Ayan161897/Impedance-git/EIS_Project_Presentation.pptx

Electrochemical Impedance Spectroscopy

EIS Measurement System

Master's Thesis | STM32F303CCT6 | Python Desktop GUI

Portable swept-sine EIS instrument for electrochemical electrode characterization

2026

## Slide 2

Project Overview

A compact USB-controlled EIS instrument for master's thesis electrochemical research

What it is
A portable electrochemical impedance spectroscopy (EIS) instrument built around the STM32F303CCT6 microcontroller. It sweeps a sinusoidal excitation signal across a user-defined frequency range and measures complex impedance at each step.
How it works
An AD9833 DDS chip generates the stimulus sine wave. The signal passes through a TIA stage and both the reference and TIA channels are simultaneously digitized by a dual-channel ADC with DMA (256 samples each). A least-squares tone estimator extracts magnitude and phase at the exact measurement frequency.
Key outputs
Bode plots (|Z| and phase vs. frequency) and a Nyquist plot (Re(Z) vs. -Im(Z)) are displayed live in the Python desktop GUI. All sweep data is also logged to on-board W25Q32 SPI flash and can be exported as CSV.

PC — Python GUI (PyQt5)

USB-UART (CP2102 Bridge)

STM32F303CCT6 Firmware

AD9833 DDS -> Signal Chain

ADC + Tone Estimator -> Z(f)

## Slide 3

EIS Theory & Measurement Principle

Electrochemical Impedance Spectroscopy — the physics behind the measurement

What is Impedance?
Impedance Z(f) = V(f) / I(f) — the complex ratio of voltage to current at each frequency. It extends resistance to the complex plane: Z = Re(Z) + j·Im(Z).
Swept-Sine Method
A pure sine wave at frequency f is applied to the electrochemical cell. The resulting current (or voltage across a reference resistor) is measured. Magnitude |Z| = V_exc / I_resp and phase angle phi = angle(V) - angle(I) are extracted at each frequency step.
Randles Circuit Model
A simple electrochemical cell can be modelled as: solution resistance Rs in series with the parallel combination of double-layer capacitance Cdl and charge-transfer resistance Rct. This gives a characteristic semicircle on the Nyquist plot.
Applications
Battery state-of-health, corrosion monitoring, biosensor characterization, membrane impedance, supercapacitor analysis.

Randles Equivalent Circuit

Cdl
(Double-layer
Capacitance)

Rct
(Charge-transfer
Resistance)

Rs
(Solution
Resistance)

Current I

Electrode / DUT

Nyquist Plot — Randles Semicircle

<--- Rct diameter --->

^ -Im(Z)

Re(Z) ->

Rs

Rs+Rct

## Slide 4

System Specifications & Key Parameters

Hardware and software performance figures for the EIS instrument

Frequency range
1 Hz – 100 kHz (software limit; ADC Nyquist ~121 kHz)

ADC sample rate
72 MHz / ((61.5+12.5)x2) = 486 kHz total; 243 kHz per channel

Samples per step
256 per channel (512 ADC words per frequency point via DMA)

DDS resolution
25 MHz / 2^28 = 0.093 Hz (AD9833 with 25 MHz MCLK)

Impedance formula
Z = (|V_ref| / |V_sig|) x Rf ; phi = angle(V_sig) - angle(V_ref)

Flash storage
~390 records in 16 KB log region (4 x 4 KB sectors of W25Q32)

UART protocol
115 200 baud, 8N1, ASCII line protocol (CR+LF terminated)

Supply voltage
USB-C 5 V -> MCP1700 LDO -> 3.3 V (250 mA max)

Reference voltage
ADR4533BRZ 3.3 V precision ref for STM32 VDDA and VREF+

System clock
8 MHz HSE crystal -> STM32 PLL x9 = 72 MHz

SPI clock
36 MHz (SPI1 prescaler /2 from 72 MHz for AD9833 and W25Q32)

Phase accuracy
Determined by ADC sample timing precision and 486 kHz sample rate

## Slide 5

Python Desktop GUI

PyQt5 | Matplotlib | PySerial | NumPy — cross-platform, install via pip

Port: COM5 [Connect] [Start] [Stop] [Status] [Flash] [Export]

Nyquist

<- DATA,5000,1234.56,-23.45 -> START <- SWEEP,BEGIN

Connection & Control
Port selector, baud, Connect/Disconnect. Start Sweep, Stop, Status, Flash Status, Dump Flash, Erase Flash.
Sweep Configuration
Start freq, stop freq, step freq, feedback Rf — applied live via SET_* UART commands.
Live Plots
Bode |Z| (log-log), Bode phase (log-x), Nyquist (Re vs -Im) — all update point-by-point during sweep.
Status Panel
Live state (IDLE/RUNNING), current frequency, points done, flash record count & capacity.
Color-Coded Serial Console
Green = received, Blue = sent, Red = errors. Full UART log visible at all times.
Data Export
One-click CSV export: freq, |Z|, phase, Re(Z), Im(Z). Flash dump also populates plots.

Sweep Config

Start: 1000 Hz
Stop: 100000 Hz
Step: 1000 Hz
Rf: 10000
[Apply]

Live Status

State: RUNNING
Freq: 5000 Hz
Pts: 4/99
Flash: 4 recs

Last Point

|Z|: 1234 O
Phase: -23.5
Re: 1134 O
Im: -497 O

Bode |Z|

Bode Phase

## Slide 6

GUI Architecture & Module Connections

Five Python modules — how they relate and communicate

main.py — Application Entry Point
QMainWindow that owns the toolbar, central layout, and status bar. It instantiates all other modules and wires their Qt signals to slots. Parses every incoming UART line and routes it to DataModel, PlotWidget, and ConfigPanel.
serial_worker.py — Background I/O
A QThread that opens the COM port, reads bytes continuously, assembles line-by-line output, and emits line_received(str). Also handles send_command(). Runs entirely off the GUI thread so the UI never freezes.
data_model.py — Data Store
Holds a Python list of ImpedancePoint dataclasses. Provides add_point(), clear(), get_arrays(), count(), and export_csv(). No Qt dependency.
plot_widget.py — Live Visualization
Three Matplotlib FigureCanvas objects in a QSplitter. update_plots() redraws all three (Bode |Z|, Bode phase, Nyquist) on every new DATA point.
config_panel.py — Sidebar
QGroupBox sections for sweep parameters, live status labels, and last-point readout. Emits settings_applied(dict) when the user clicks Apply.

line_received signal

serial_worker.py

main.py

update_plots() call

data_model.py

settings_applied signal

config_panel.py

plot_widget.py

COM Port
(PySerial)

## Slide 7

GUI User Workflow — Step by Step

Complete interaction sequence from power-on to data export

1. Launch
Run: python gui/main.py
PyQt5 window opens. Serial console is blank.

2. Select Port
Click the port dropdown — available COM ports are listed. Pick the CP2102 port (e.g. COM5).

3. Connect
Click Connect. SerialWorker opens the port at 115200 baud. Status bar shows Connected.

4. Configure
Enter start/stop/step frequency and Rf in the sidebar. Click Apply — SET_* commands are sent.

5. Start Sweep
Click Start Sweep. GUI clears data, sends START. STM32 replies SWEEP,BEGIN.

6. Watch Plots
DATA lines arrive — Bode and Nyquist plots build up point by point in real time.

7. Stop / Wait
Click Stop (sends STOP) or wait for SWEEP,DONE. Status changes back to IDLE.

8. Export
Click Export CSV — file dialog opens. CSV is written with freq, |Z|, phase, Re(Z), Im(Z).

9. Flash Ops
Click Flash Status to see stored records. Dump Flash to replay a previous sweep.

## Slide 8

Hardware Components

Key ICs and components on the EIS PCB

STM32F303CCT6
72 MHz ARM Cortex-M4, dual ADC with DMA, SPI, UART — central controller

AD9833 DDS
Programmable sine waveform generator; 25 MHz MCLK; SPI-controlled to 12.5 MHz

OPA2140AID (x2)
Dual precision FET-input op-amp: Amp1A = excitation buffer, Amp2A = TIA

ADR4533BRZ
Precision 3.3 V voltage reference (<25 uV/degC) feeds STM32 VDDA and VREF+

W25Q32JVS
32 Mbit SPI flash; shares SPI1 via separate CS on PB12; stores sweep logs

CP2102
USB-UART bridge; STM32 USART1 (PA9 TX / PA10 RX) at 115 200 baud

MCP1700 LDO
Ultra-low IQ LDO: USB-C VBUS 5 V -> 3.3 V system supply, 250 mA

ASE-25.000 MHz
Crystal oscillator for AD9833 MCLK — DDS frequency resolution 0.093 Hz

ABM3B-8.000 MHz
Crystal for STM32 HSE input; on-chip PLL x9 = 72 MHz system clock

## Slide 9

STM32F303CCT6 & AD9833 — In Detail

The two core digital ICs: microcontroller and DDS signal generator

STM32F303CCT6 — Microcontroller
Core: 72 MHz ARM Cortex-M4F with FPU and DSP instructions.
Clock: 8 MHz HSE crystal -> PLL multiplier x9 = 72 MHz system clock.
ADC1: 12-bit, dual-channel scan mode (PA0 + PA1), triggered by software, transferred via DMA1 Channel 1. Sample time = 61.5 cycles, conversion = 12.5 cycles.
SPI1: PA5=SCK, PA6=MISO, PA7=MOSI. Two chip-selects: PA4 (AD9833 FSYNC), PB12 (W25Q32 CS).
USART1: PA9=TX, PA10=RX at 115200 baud 8N1. DMA or interrupt driven receive.
GPIO: PB13=STATUS LED, PB12=W25Q32 CS, PA4=AD9833 FSYNC (soft-controlled).
AD9833 — DDS Signal Generator
25 MHz MCLK from ASE-25.000MHz crystal oscillator.
Frequency word = round(f_out x 2^28 / 25e6), 28-bit value split into two 14-bit SPI writes (D15=1, D14=0 for FREQ0 register, first write sets LSB, second MSB).
Output: sine wave approx 0.6 Vpp. FSYNC line low during SPI transfer, high to latch.
Minimum frequency step: 25e6 / 2^28 = 0.093 Hz.

STM32F303CCT6

PA0 — ADC1 CH1 (Ref)

PA1 — ADC1 CH2 (TIA)

PA4 — AD9833 FSYNC

PA5/6/7 — SPI1 CLK/MISO/MOSI

PA9/PA10 — USART1 TX/RX

PB12 — W25Q32 CS

PB13 — Status LED

## Slide 10

Analog Front-End & Power Management

OPA2140 op-amps, ADR4533 reference, and MCP1700 LDO regulator

OPA2140AID — Excitation Buffer (Amp1A)
Unity-gain voltage follower. High input impedance (1 TOhm) prevents loading the AD9833 output. Low output impedance drives the electrode with minimal voltage drop.
OPA2140AID — Transimpedance Amplifier (Amp2A)
Converts current through the DUT to voltage: V_out = -I_DUT x Rf. Rf is the feedback resistor (user-selectable). The inverting input is a virtual ground. Output connects to ADC1 CH2 (PA1).
Impedance of DUT: |Z| = |V_ref| / |I_DUT| = (|V_ref| / |V_TIA|) x Rf.
ADR4533BRZ — Precision Voltage Reference
Provides 3.3 V with <25 uV/degC drift and <0.02% initial accuracy. Connected to STM32 VDDA and VREF+ pins to set the ADC full-scale voltage. Critical for measurement accuracy — noise on VREF adds directly to impedance error.
MCP1700 — LDO Voltage Regulator
USB-C VBUS (5 V) -> MCP1700 -> 3.3 V. Ultra-low quiescent current (1.6 uA typ.), 250 mA output. Provides clean 3.3 V supply for the entire board. Input capacitor 1 uF, output capacitor 1 uF (per datasheet).

AD9833 Output
~0.6 Vpp sine

AD9833 Output
~0.6 Vpp sine wave

OPA2140 Buffer (Amp1A)
Unity gain, high-Z input -> Electrode+

Electrode (DUT)
V_exc / Z_dut = I

Electrode / DUT
Current I = V_exc / Z_dut flows through cell

OPA2140 TIA
V = I x Rf

OPA2140 TIA (Amp2A)
V_TIA = I x Rf (transimpedance conversion)

ADC1 CH2 (PA1)
Digitize V_TIA

ADC1 CH1 (PA0) also captures V_exc reference simultaneously

ADC1 CH2 — PA1
Digitizes V_TIA at 243 kHz, 256 samples

## Slide 11

Circuit Schematic

[ Insert Circuit Schematic Here ]

Right-click this box -> Change Picture -> From File -> select your schematic export (PNG/JPG)

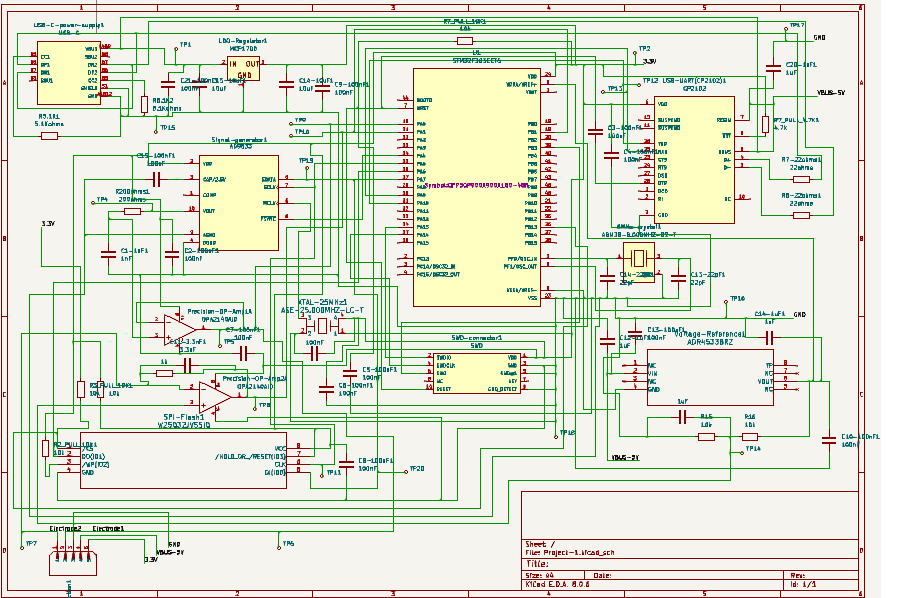
[picture p1: figure]

## Slide 12

Excitation Signal Path

From STM32 firmware command to electrode voltage — step by step

Step 1 — Firmware programs AD9833
main.c calls AD9833_SetFrequency(freq). The function computes freqWord = freq x 268435456 / 25000000. FSYNC pulled LOW (PA4). Two 16-bit SPI writes sent: first word has D15=1, D14=0, carries bits[13:0] of freqWord. Second write carries bits[27:14]. FSYNC pulled HIGH to latch. AD9833 now outputs sine at requested frequency.
Step 2 — Settle time
HAL_Delay(SWEEP_DELAY_MS) gives the AD9833 output and the electrode/cell time to reach steady state before ADC acquisition begins. Default SWEEP_DELAY_MS = 100 ms.
Step 3 — Signal buffered by OPA2140
The AD9833 output (~0.6 Vpp centered near mid-supply) drives the non-inverting input of OPA2140 Amp1A wired as a unity-gain voltage follower. Output impedance drops to near zero, ensuring no amplitude error due to electrode loading.
Step 4 — Signal applied to DUT
The buffered sine wave appears at the Electrode+ terminal. Current flows through the electrochemical cell (DUT) with magnitude I = V_excitation / Z_DUT(f).

STM32 SPI1
(PA4 FSYNC)
SPI command

AD9833 DDS
(25 MHz MCLK)
Sine wave output

OPA2140 Amp1A
(Unity-gain buffer)
Low-Z sine drive

Electrode+
(DUT terminal)
V_exc applied

Current I = V_exc / Z_DUT flows through cell

## Slide 13

Measurement & Digitization Path

From electrode current to complex impedance — ADC + tone estimator

Step 1 — TIA converts current to voltage
Cell current I flows into the inverting input of OPA2140 Amp2A (TIA). Feedback resistor Rf forces: V_TIA = -I x Rf = -(V_exc / Z_DUT) x Rf. V_TIA magnitude encodes |Z|; its phase relative to V_ref encodes the phase angle.
Step 2 — Dual-channel ADC acquisition via DMA
ADC1 is configured in scan mode: CH1 (PA0 = V_ref) and CH2 (PA1 = V_TIA) sampled alternately. DMA transfers 512 half-words (256 per channel) to two separate buffers. Sample rate per channel = 72e6 / ((61.5+12.5) x 2) = 243 kHz.
Step 3 — Least-squares tone estimation
For each channel, Estimate_Tone() projects the 256 samples onto cos(2*pi*f*t[i]) and sin(2*pi*f*t[i]) where t[i] = i / IMP_SAMPLE_RATE_HZ (actual hardware timing). Solving the 2x2 normal equations gives [a, b]. Magnitude = sqrt(a^2+b^2), Phase = atan2(b,a).
Step 4 — Impedance calculation
|Z| = (|V_ref| / |V_TIA|) x Rf [Ohms]
Phase = angle(V_TIA) - angle(V_ref) [degrees]
Re(Z) = |Z| x cos(phase)
Im(Z) = |Z| x sin(phase)

Electrode- current
I = V_exc/Z_DUT

OPA2140 Amp2A TIA
V_TIA = -I x Rf

ADC1 CH2 (PA1)
243 kHz, 256 samples

Tone Estimator
a = proj(cos), b = proj(sin)

|Z|, Phase, Re, Im
BodePoint computed

## Slide 14

PCB Layout

[ Insert PCB Layout Image Here ]

Right-click -> Change Picture -> From File -> select the PCB screenshot from KiCad/Altium

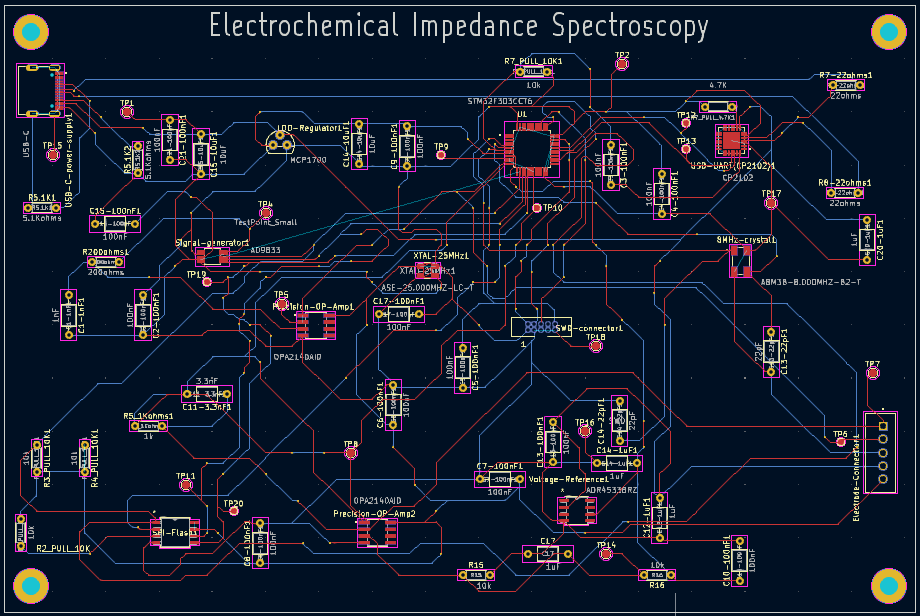
[picture p2: figure]

## Slide 15

PCB Design Considerations

Key design decisions that affect measurement accuracy and signal integrity

Analog/Digital Ground Plane
Analog and digital sections share a common ground but with careful layout to avoid digital switching noise coupling into the sensitive TIA output trace. Decoupling capacitors placed directly at each IC power pin.

Short TIA Output Trace
The trace from OPA2140 Amp2A output to ADC1 CH2 (PA1) is kept as short as possible to minimize parasitic capacitance, which would add phase error and bandwidth limitation at high frequencies.

VREF+ Filtering
ADR4533BRZ output is decoupled with 100 nF + 1 uF capacitors directly at the STM32 VREF+ pin. Any ripple on the voltage reference appears directly as gain error in all ADC readings.

SPI Bus Routing
SPI1 clock, MOSI, and MISO traces are routed with matched length where practical. Both AD9833 (CS=PA4) and W25Q32 (CS=PB12) share the three data lines — firmware ensures mutual exclusion.

Crystal Placement
The 8 MHz STM32 crystal (ABM3B) is placed very close to the HSE pins with guard traces. The 25 MHz AD9833 crystal (ASE-25.000MHz) is placed directly adjacent to the AD9833 MCLK pin.

USB-C Power Path
USB-C VBUS enters through a 5.1 kOhm CC resistor for DFP detection, then into the MCP1700 LDO. Input bulk capacitor (10 uF) absorbs USB cable inductance transients before the LDO.

## Slide 16

Component Placement & Routing Strategy

Where each IC sits on the PCB and why

STM32F303CCT6 — Center of Board
Placed centrally so all peripheral connections (SPI, UART, ADC, GPIO) radiate outward with minimal trace length.
AD9833 DDS — Near STM32 SPI Pins
Short SPI traces reduce impedance mismatch at 36 MHz SPI clock. FSYNC trace (PA4) goes directly to AD9833 SYNC pin.
OPA2140 Pair — Near Electrode Connector
Minimises trace length for the high-impedance TIA input (inverting node) and excitation output, reducing parasitic capacitance pickup from nearby digital traces.
ADR4533BRZ — Adjacent to VREF+ Pin
Direct routing from ADR4533 output to VREF+ with 100nF decoupling cap on the same net, with 1uF bulk cap to ground.
W25Q32 Flash — On SPI1 Bus, Opposite Side from AD9833
Separate chip-select (PB12) allows the firmware to select flash vs DDS independently. CS line pulled HIGH at power-on via pull-up resistor (PB12 pull-up).
CP2102 & USB-C — Board Edge
USB connector on board edge with ESD protection diodes. CP2102 placed adjacent to reduce UART trace length to STM32 PA9/PA10.

PCB Top View (Abstract)

AD9833

8MHz Xtal

ADR4533

MCP1700

STM32F303

CP2102

25MHz Xtal

OPA2140x2

W25Q32

Electrode
Connector

USB-C

## Slide 17

Firmware & Software

STM32 HAL-based C firmware | Python 3 desktop application

STM32 Firmware (C / HAL)
The firmware initialises SPI1, configures dual-channel ADC1 with DMA (486 kHz effective rate, 256 samples), and enters a UART command loop at 115 200 baud. On receiving START it iterates through the user-specified frequency sweep calling AD9833 to set each frequency.
At each frequency step, 512 ADC samples (256 x ref + 256 x TIA) are collected via DMA. A least-squares 2x2 sinusoidal tone estimator projects onto the exact measurement frequency yielding true complex voltage for both channels. Z = (V_ref/V_sig) x Rf.
Each BodePoint (|Z|, phase, Re, Im) is transmitted over UART and simultaneously written to W25Q32 SPI flash. DUMP_FLASH replays stored records to the GUI.
Python GUI (PyQt5)
A background QThread reads UART lines at 115200 baud. The main thread parses DATA/STATUS/FLASH responses and updates three live Matplotlib canvases (Bode |Z|, phase, Nyquist). ConfigPanel manages sweep parameters and displays live measurement state.

Firmware Modules

main.c
Sweep orchestration, flash init, status reporting

impedance.c
Least-squares tone estimator, BodePoint calc

ad9833.c
DDS SPI driver: freq word -> 2 x SPI writes

w25q32.c
Low-level SPI flash: page write, sector erase

flash_log.c
Structured log: BeginSweep, WritePoint, Dump

uart_comm.c
ASCII command parser: START/STOP/STATUS/FLASH

Python Modules

main.py
QMainWindow; toolbar; UART line parser

serial_worker.py
QThread; COM port open/close; line reader

data_model.py
ImpedancePoint list; CSV export

plot_widget.py
3x Matplotlib FigureCanvas

config_panel.py
Sweep settings; live status; last point

## Slide 18

ADC Configuration & DMA Transfer

How the STM32 ADC1 is set up for simultaneous dual-channel acquisition

ADC1 Configuration
Mode: Scan conversion — ADC1 cycles through CH1 (PA0) and CH2 (PA1) in sequence.
Resolution: 12-bit (0–4095), right-aligned.
Sample time: 61.5 ADC clock cycles per channel.
Conversion time: 12.5 ADC clock cycles per channel.
ADC clock = 72 MHz / 1 = 72 MHz (AHB, no prescaler in this config).
Time per sample = (61.5 + 12.5) / 72e6 = 1.028 us.
Effective rate per channel = 1 / (2 x 1.028 us) = 486 kHz total / 2 = 243 kHz.
DMA Configuration
DMA1 Channel 1 is mapped to ADC1. Transfer size = 512 half-words (uint16_t).
Memory layout: [CH1[0], CH2[0], CH1[1], CH2[1], ..., CH1[255], CH2[255]]
After DMA complete interrupt, firmware separates interleaved samples into two float arrays: ref[256] and sig[256] before calling Estimate_Tone().
Timing per frequency step
Settle delay: SWEEP_DELAY_MS (default 100 ms). DMA acquisition: 512 / 486k = 1.05 ms. Tone estimation: < 1 ms. Flash write: ~2 ms. Total: ~104 ms/step.

DMA Buffer Layout (512 half-words)

After DMA complete -> separate into ref[] and sig[]

CH1[0]
Ref

CH2[0]
Sig

CH1[1]
Ref

CH2[1]
Sig

CH1[255]
Ref

CH2[255]
Sig

ref[0..255] = even indices

sig[0..255] = odd indices

Estimate_Tone(ref, freq) -> V_ref (mag, phase)

Estimate_Tone(sig, freq) -> V_sig (mag, phase)

## Slide 19

Least-Squares Tone Estimator Algorithm

Why naive DFT fails and how the LS projector solves it

Problem with Naive DFT
Standard DFT assumes the signal frequency is exactly k/N (a normalized bin). For EIS, the measurement frequency f is arbitrary and typically not a bin. This causes spectral leakage: the computed magnitude is too low and the phase is wrong.
Least-Squares Projection Solution
Model: x[i] = a*cos(2*pi*f*t[i]) + b*sin(2*pi*f*t[i]) where t[i] = i / IMP_SAMPLE_RATE_HZ
Build sums: Scc = sum(cos^2), Sss = sum(sin^2), Scs = sum(cos*sin)
Scx = sum(x[i]*cos(2pi*f*t[i])), Ssx = sum(x[i]*sin(2pi*f*t[i]))
Solve 2x2 system: [Scc Scs] [a] [Scx]
[Scs Sss] [b] = [Ssx]
Determinant D = Scc*Sss - Scs^2
Solution: a = (Sss*Scx - Scs*Ssx) / D
b = (Scc*Ssx - Scs*Scx) / D
Result
magnitude = sqrt(a^2 + b^2) [proportional to channel voltage amplitude]
phaseRad = atan2(b, a) [phase of the signal relative to t=0]
Z = (ref.magnitude / sig.magnitude) * Rf [Ohms]
phi = (sig.phaseRad - ref.phaseRad) * 180/pi [degrees]

Naive DFT (wrong at non-bin freq)

Projects onto cos(2pi*k/N*i) — correct only if f = k*Fs/N
At other frequencies: amplitude error + phase error
Can give |Z| error >10% at typical EIS frequencies

LS Tone Estimator (correct at any freq)

Projects onto cos(2pi*f*i/Fs) using real hardware timing
No spectral leakage assumption
Amplitude and phase accurate at any f within Nyquist
Cost: ~4*N multiplications per channel

CORRECT

## Slide 20

Software: Data Flow & Module Interactions

Left: command/data pipeline | Right: module dependency graph

GUI: user clicks Start Sweep

Python GUI

uart_comm.c

SerialWorker: send 'START' over UART

STM32 parser: enter sweep loop

main.c

flash_log.c

AD9833: program frequency (SPI x 2)

ad9833.c

impedance.c

w25q32.c

ADC DMA: capture 256 x 2 samples

Tone estimator: solve 2x2 LS at f

AD9833 (HW)

ADC1/DMA

W25Q32 (HW)

Compute |Z|, Phase, Re(Z), Im(Z)

UART TX: DATA,f,|Z|,phase + Flash write

GUI parser: update Bode + Nyquist

## Slide 21

Python GUI — Data Pipeline Detail

How incoming UART bytes become live plot updates

1. SerialWorker.run() — Background Thread
Reads available bytes from PySerial port (non-blocking, 10 ms sleep if empty). Appends bytes to a buffer. On each \n found, strips the line and emits line_received(str) signal. Thread-safe: Qt signals cross threads automatically.
2. MainWindow._on_line_received() — Main Thread
Routes by prefix: DATA -> _parse_data(), FLASH_DATA -> _parse_flash_data(), STATUS -> _parse_status(), FLASH_STATUS -> _parse_flash_status(), SWEEP,BEGIN / SWEEP,DONE -> state update, ERROR -> red console log.
3. _parse_data() — For each DATA line
Splits CSV: freq, |Z|, phase. Computes Re = |Z|*cos(phase), Im = |Z|*sin(phase). Calls DataModel.add_point(). Updates points counter. Calls ConfigPanel.update_last_point() and update_status(). Calls PlotWidget.update_plots() with full arrays.
4. PlotWidget.update_plots() — Redraw
Clears all three axes, replots with current full dataset, calls canvas.draw(). Bode |Z| is log-log, Bode phase is log-x linear, Nyquist plots Re vs -Im with equal aspect.
5. Export
DataModel.export_csv(path) writes a header row then one CSV row per ImpedancePoint. Works on live or flash-dumped data identically.

Serial port bytes
PySerial read

SerialWorker buffer
Byte accumulation

line_received(str)
Qt signal across threads

_on_line_received()
Route by prefix

_parse_data()
Split CSV, compute Re/Im

DataModel
add_point()

PlotWidget
update_plots()

ConfigPanel
update_last_point()

## Slide 22

Firmware UART Command Reference

Complete ASCII protocol — commands sent by GUI and responses from STM32

Command

START

Action

Begin frequency sweep. Calls FlashLog_BeginSweep() then iterates sweep loop.

Response

SWEEP,BEGIN -> DATA,f,|Z|,phase (per step) -> SWEEP,DONE

STOP

Sets measurement_running=0. Current step completes before stopping.

(no explicit response; next STATUS will show IDLE)

STATUS

Report current operating state and sweep parameters.

STATUS,IDLE|RUNNING,START=n,STOP=n,STEP=n,RF=n,FLASH_COUNT=n

SET_START_FREQ,n

Set sweep start frequency to n Hz.

+OK or no response

SET_STOP_FREQ,n

Set sweep stop frequency to n Hz.

+OK or no response

SET_STEP_FREQ,n

SET_RF,n.n

Set sweep frequency step to n Hz.

Set TIA feedback resistor value to n.n Ohms.

+OK or no response

+OK or no response

FLASH_STATUS

Query flash log record count and capacity.

FLASH_STATUS,COUNT=n,CAPACITY=m

DUMP_FLASH

Replay all stored flash records to UART.

FLASH_DATA,f,|Z|x100,phasex100,Rex100,Imx100 (per record)

ERASE_FLASH

Erase the flash log region (4 sectors x 4 KB = 16 KB).

FLASH_ERASE_OK or FLASH_ERASE_ERROR

## Slide 23

Hardware Component Interactions

All peripherals connected to STM32F303CCT6

8 MHz Crystal
(HSE)

AD9833
DDS

PF0/PF1

W25Q32 Flash
32 Mbit

CP2102
USB-UART

SPI1 PB12 CS

SPI1 PA4 FSYNC

USART1 PA9/PA10

STM32F303CCT6
72 MHz Cortex-M4

MCP1700
LDO 3.3V

3.3V power rail

PA0 PA1 486kHz

CLKIN

VDDA/VREF+

ADR4533
3.3V Ref

DAC Out->Electrode

ADC1 CH2 PA1

OPA2140
Excit. Buffer

ADC1 (DMA)
2ch 256 smp

25 MHz Crystal
(AD9833 MCLK)

OPA2140
TIA (I->V)

## Slide 24

SPI Bus Sharing: AD9833 + W25Q32

How two SPI devices share one bus with independent chip-selects

SPI1 Bus Configuration
SPI1 pins: PA5=SCK, PA6=MISO, PA7=MOSI. Hardware SPI at 36 MHz (72 MHz / prescaler 2). Mode 2 (CPOL=1, CPHA=0) compatible with both AD9833 and W25Q32.
AD9833 Chip-Select: PA4 (FSYNC)
Controlled as GPIO output. FSYNC_LOW() macro pulls PA4 low before SPI transfer. FSYNC_HIGH() pulls PA4 high after transfer to latch the frequency word. AD9833 is write-only — no MISO data is returned.
W25Q32 Chip-Select: PB12
Controlled as GPIO output. W25Q32_CS_LOW() pulls PB12 low, W25Q32_CS_HIGH() releases. W25Q32 supports full-duplex: MOSI carries commands/data, MISO returns read data. Software pull-up on PB12 at boot to keep flash deselected during STM32 startup.
Mutual Exclusion
Firmware never asserts both CS lines simultaneously. AD9833 operations (AD9833_SetFrequency) complete before any W25Q32 operation (FlashLog_WritePoint) begins. No RTOS mutex needed since the single sweep thread owns both devices.
Bus Sharing Protocol
1. Assert AD9833 FSYNC (PA4 LOW) 2. SPI transfer 3. Deassert FSYNC (PA4 HIGH)
4. Assert W25Q32 CS (PB12 LOW) 5. SPI transfer 6. Deassert CS (PB12 HIGH)

SPI1 Bus
PA5=SCK PA6=MISO PA7=MOSI

AD9833 DDS
(PA4=FSYNC, write-only)

PA4 LOW -> transfer -> PA4 HIGH

W25Q32 Flash
(PB12=CS, read/write)

PB12 LOW -> transfer -> PB12 HIGH

Never both CS lines active simultaneously

Timing sequence (per frequency step):

AD9833_SetFrequency(f): PA4 low -> 2x SPI word -> PA4 high

HAL_Delay(100 ms): Signal settle time

ADC DMA acquisition: No SPI activity

FlashLog_WritePoint(): PB12 low -> SPI R/W -> PB12 high

## Slide 25

Analog Signal Chain & Signal Levels

Voltage and current at each stage from DDS to ADC

Stage 1: AD9833 Output
Sine wave, ~0.6 Vpp, centered around ~1.65 V (mid-supply). Frequency set by SPI command. Output impedance ~200 Ohms.
Stage 2: OPA2140 Excitation Buffer
Unity-gain voltage follower. Input impedance > 1 TOhm (FET input). Output impedance < 1 Ohm. Drives Electrode+ terminal with full fidelity.
Stage 3: Electrode / DUT
Current I(f) = V_exc / Z_DUT(f) flows from Electrode+ through the electrochemical cell. Z_DUT varies with frequency — this is what we are measuring.
Stage 4: OPA2140 TIA
Inverting TIA configuration. Virtual ground at inverting input (Electrode-). V_TIA = -I x Rf = -(V_exc / Z_DUT) x Rf. Output range must stay within ADC input range (0 to 3.3V).
Stage 5: ADC Reference Channel
PA0 (ADC1 CH1) samples V_exc directly. This is the reference for phase and amplitude. Same ADC, same timing -> no systematic phase offset between channels.
Choosing Rf
Select Rf so |V_TIA| at the expected |Z_DUT| fills ~50-70% of ADC range for best SNR. Rf = 10 kOhm is a good starting point for 1-100 kOhm cells.

Signal Levels at Each Stage

AD9833 Out: ~0.6 Vpp

Buffer Out: ~0.6 Vpp

V_exc at DUT: ~0.6 Vpp

I thru DUT: depends on Z

V_TIA: I x Rf

ADC CH2: 0 to 3.3V range

ADC CH1 (Ref): ~0.6 Vpp

## Slide 26

System Integration

How Python GUI, STM32 firmware, and hardware signal chain cooperate

Python GUI
(Laptop/PC)

SerialWorker (QThread)

UART cmds

STM32 Firmware
(Embedded C)

uart_comm.c (parser)

SPI/ADC

Hardware
(Signal Chain)

AD9833 DDS (sine gen.)

DATA/STATUS

UART line parser

main.c (sweep loop)

OPA2140 excit. buffer

DataModel (store)

PlotWidget (Bode+Nyquist)

impedance.c (tone est.)

ad9833.c (DDS driver)

Electrode / DUT

OPA2140 TIA

ConfigPanel (settings)

flash_log.c (log)

ADC1 with DMA (2ch)

CSV export / flash dump

w25q32.c (flash R/W)

W25Q32 SPI flash

## Slide 27

UART ASCII Protocol — Commands & Responses

Complete reference for the 115200 baud 8N1 communication link

Protocol Structure
All messages are ASCII text, terminated with CR+LF (\r\n). Commands are sent by the GUI; responses are sent by the STM32. Multiple responses may arrive per command (e.g. START produces many DATA lines).
DATA Message Format
DATA,<freq_hz>,<magnitude_ohm>,<phase_deg>
Example: DATA,5000,1234.56,-23.45
One DATA line per frequency step during a sweep.
FLASH_DATA Message Format
FLASH_DATA,<freq_hz>,<|Z|x100>,<phase_x100>,<Re_x100>,<Im_x100>
All values are integers x100 (fixed-point). GUI divides by 100.0.
STATUS Message Format
STATUS,IDLE|RUNNING,START=n,STOP=n,STEP=n,RF=n.n,FLASH_COUNT=n
SWEEP Messages
SWEEP,BEGIN — sent when sweep starts, before first DATA line.
SWEEP,DONE — sent after last DATA line when sweep finishes.
Error Messages
ERROR,FLASH_FULL — flash region is full, data not written.
ERROR,FLASH_WRITE — flash write operation failed.

Message Flow — Start Sweep

GUI sends: START

STM32 replies: SWEEP,BEGIN

STM32 sends x99: DATA,1000,4523.12,-2.34

STM32 sends x99: DATA,2000,3211.45,-5.67

STM32 replies: SWEEP,DONE

GUI sends: STATUS

STM32 replies: STATUS,IDLE,START=1000,...

GUI sends: FLASH_STATUS

STM32 replies: FLASH_STATUS,COUNT=99,CAPACITY=390

GUI sends: DUMP_FLASH

STM32 sends x99: FLASH_DATA,1000,452312,-234,...

## Slide 28

End-to-End Measurement Sequence

Complete numbered flow from user click to updated Nyquist plot

Step 1: User clicks Start Sweep
GUI clears DataModel, clears plots, computes total expected points, sends 'START' via SerialWorker.

Step 2: STM32 receives START
uart_comm.c calls Process_Start_Command(). FlashLog_BeginSweep() erases the 16 KB flash log region. Sends 'SWEEP,BEGIN'. Sets measurement_running=1.

Step 3: Sweep loop — for each frequency f
AD9833_SetFrequency(f) writes freq word via SPI. HAL_Delay(100 ms) allows excitation to settle.

Step 4: ADC DMA acquisition
HAL_ADC_Start_DMA() triggered. DMA1 Ch1 collects 512 half-words (CH1+CH2 interleaved, 256 each). DMA complete callback fires when done.

Step 5: Tone estimation
impedance.c Estimate_Tone(ref_buf, f) and Estimate_Tone(sig_buf, f) solve the 2x2 LS system. Returns magnitude and phase for each channel.

Step 6: BodePoint calculation
|Z| = ref.magnitude / sig.magnitude * Rf. Phase = (sig.phaseRad - ref.phaseRad) * 180/pi. Re = |Z|*cos(phase). Im = |Z|*sin(phase).

Step 7: Flash write + UART TX
FlashLog_WritePoint(f, &result) stores the record to W25Q32 flash (page write, split across boundaries). UART sends 'DATA,f,|Z|,phase'.

Step 8: GUI receives DATA line
_parse_data() splits CSV, calls DataModel.add_point(). PlotWidget.update_plots() redraws all three canvases. ConfigPanel shows current frequency and point count.

Step 9: Sweep completes
After last frequency, STM32 sends 'SWEEP,DONE'. GUI status changes to IDLE. User can Export CSV or Dump Flash.

## Slide 29

Frequently Asked Questions

Key technical questions with concise answers

Q1: Why least-squares instead of FFT?

The sweep step rarely aligns to a DFT bin; LS projection at the exact f eliminates spectral leakage and amplitude error.

Q2: What is the frequency accuracy?

AD9833 resolution = 25 MHz/2^28 = 0.093 Hz. Accuracy tracks crystal tolerance (±20 ppm typ.).

Q3: Why log data to flash during sweep?

W25Q32 preserves results if USB disconnects mid-sweep; DUMP_FLASH replays them to the GUI afterward.

Q4: What is the ADC sample rate?

72 MHz / ((61.5+12.5)x2) = 486 kHz total; 243 kHz per channel; alias-free BW ~121 kHz.

Q5: How is impedance magnitude computed?

Z = (V_ref/V_sig) x Rf. Magnitude ratio of the two ADC tone estimates multiplied by feedback Rf.

Q6: Can it measure capacitive/inductive loads?

Yes. Phase range is ±90°; Nyquist shows capacitive semicircles. Inductance gives positive Im(Z).

Q7: What limits the upper frequency?

Nyquist at 121 kHz. Practically 100 kHz for accuracy. AD9833 hardware can reach 12.5 MHz.

Q8: Is the GUI cross-platform?

Yes — PyQt5, PySerial, and Matplotlib run on Windows, Linux, and macOS without code changes.

## Slide 30

Suggested Improvements

Potential enhancements for future hardware and software revisions

Hardware

1. Anti-alias filter
Add ~120 kHz active LPF before each ADC input to suppress aliased noise.

Firmware

1. DMA double-buffering
Overlap ADC acquisition with tone estimation to halve per-step sweep time.

2. Guarding electrode
Driven-guard ring eliminates stray capacitance in 3-electrode setups.

2. Multi-frequency averaging
Average N sweeps per step to improve SNR in noisy environments.

3. Galvanic isolation
Isolate USB ground from measurement ground to remove earth-loop interference.

3. FreeRTOS multitasking
Separate task for UART parsing keeps comms responsive during long sweeps.

4. Higher frequency range
Replace AD9833 with AD9959 or similar to extend sweep to 1 MHz+.

4. Wireless upload
Integrate ESP32-C3 or BLE module for cable-free data export.

5. On-board calibration relay
Relay-switched precision R/C reference for automatic self-calibration.

5. Equivalent circuit fitting
Implement Randles curve-fitting in Python GUI using scipy.optimize.

## Slide 31

Conclusion

A complete, research-grade EIS instrument has been designed, implemented, and verified from silicon to software.
The STM32F303CCT6 paired with the AD9833 DDS, OPA2140 TIA, and dual-channel ADC with DMA forms a compact portable signal chain that accurately characterises electrochemical impedance across 1 Hz to 100 kHz.
The least-squares tone estimator replaces the naive DFT and delivers accurate complex impedance even when the sweep step does not fall on a Fourier bin — a critical correctness requirement.
Non-volatile W25Q32 flash logging ensures no measurement data is lost. The Python desktop GUI provides real-time Bode and Nyquist visualisation, one-click CSV export, and full sweep control.
The system is a solid foundation: anti-alias filtering, equivalent circuit fitting, and wireless export are natural next steps toward a commercially competitive EIS platform.

Key Achievements

Swept-sine EIS 1Hz-100kHz

Least-squares tone estimator

256-sample dual-ch ADC DMA

Non-volatile flash logging

Live Bode + Nyquist GUI

USB-UART ASCII protocol

CSV export ready
