Ayan161897/Impedance-git/PCB2/New Microsoft Word Document.docx

Things to correct.

Problem1. Pin 11 V- of op-amp is not connected to ground.

Solution1. Add a wire link from C3-100nF2 pad 1 or U9 pin 11 to GND.

Problem2. Since voltage regulator is now changed so output and Input capacitor shall also change .

Solution 2. It needs output capacitor stability. Datasheet typical circuit shows about 0.47 uF input and 22 uF output tantalum capacitor.

Problem 3. The 22 PF capacitor for 8MHZ crystal shall be changed.

Solution 3.
