Ayan161897/Impedance-git/PCB/PCB_summary en.pdf

## Summary of the requirements for PCB production on milling machines

A circuit board, especially for laboratory tests/experiments, should have:

- Connection sockets for power supply via 4mm laboratory plug on the top of the circuit board
- Jumpers must be labelled (top layer or top overlay)
- Leave sufficient space to pull the jumpers (operability)
- Test points for:
- important signals that should then be part of the elaboration
- Provide sufficient GND taps, especially if several signal curves are to be displayed simultaneously
- Labelling the test points
- Blocking capacitors
- 10uF wired on top side (cup capacitors)
- 100nF on bottom/top side near the critical components (SMD)
- Version notes/creation date on circuit boards
- Check dimensions
- Font height 80 mil
- Font width 15 mil (line width still easy to mill)

Mechanical requirements, dimensions:

- Provide fastening options (here for M3):
- Spacer bolts can be used to set the boards down Possibly provide a certain minimum length to make the boards stackable
- 3mm (120mil) hole at each corner
- It is best to place a pad for this
- Pad diameter 6.5 mm (250mil) electrically insulated from the rest of the board
- The hole should have a distance of approx. 5mm (200mil) to the edge in

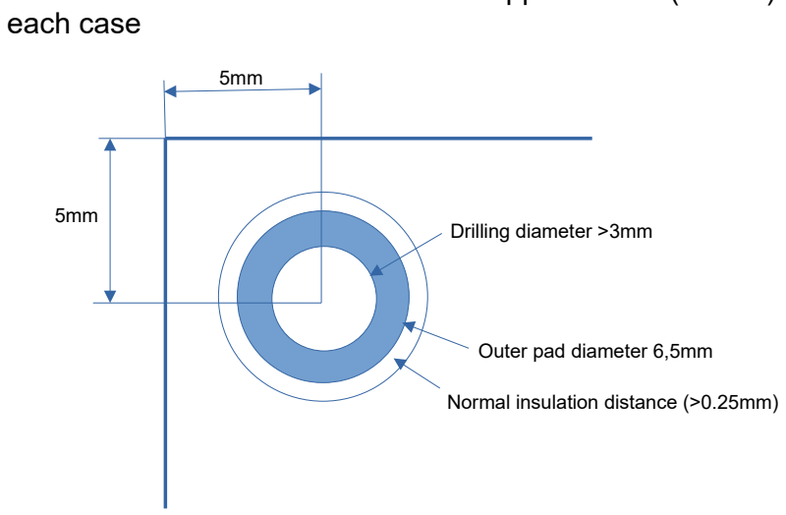
[picture p3: figure]
each case; Outer pad diameter 6,5mm; Drilling diameter >3mm; Normal insulation distance (>0.25mm)

01.07.2026 | Summary of requirements for PCBs (Peter Breitschopf) | page 1

- Requirements for tracks and drill holes:
- Insulation absolute minimum distance >0.2 mm (better 0.3 mm)
- Absolut smallest track width approx. 0.2 mm (better 0.4 mm otherwise problematic when setting the depth of the cutter)
- Smallest drill diameter >0.5mm
- Minimum distance to neighbouring conductor tracks equals insulation distance
- Current carrying capacity according to the following table

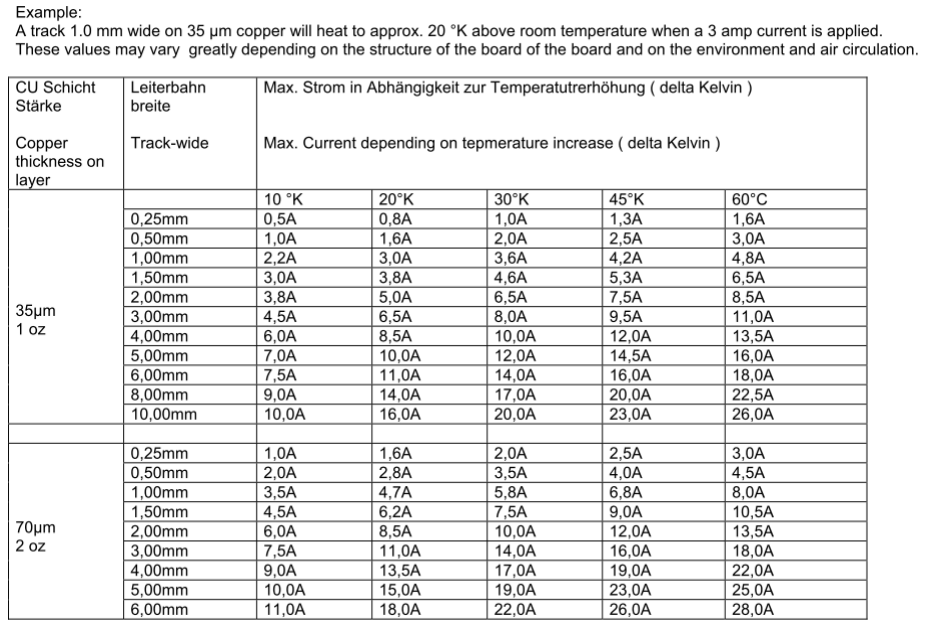
[picture p4: figure]

01.07.2026 | Summary of requirements for PCBs (Peter Breitschopf) | page 2

Trace width >0,4mm

Drilling diameter >0,5mm

Insulation distance (>0.2mm)

- Requirement for connection to large copper surfaces (self-explanatory):

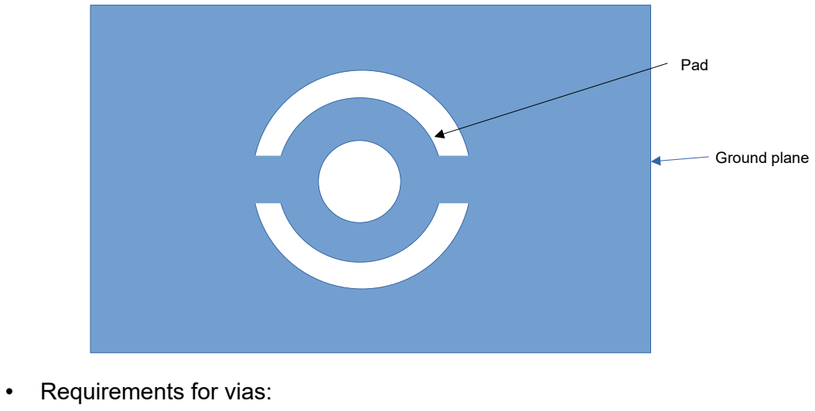
[picture p5: figure]
• Requirements for vias:; Pad; Ground plane

As a rule, we do not produce vias galvanically. It is possible to place vias manually using hollow rivets. Each individual rivet set in this way must then be pressed again.

In practice, it often makes more sense to drill smaller holes, i.e. smaller vias. The top and bottom sides are then connected to each other by soldering shortened pieces of wire.

It should be noted that the contacts of wired components must be accessible on both sides.
In the case of manufacturing PCBs with milling technique, a via must be placed at this point. The inner diameter of the via must then be larger than the wire diameter.

With some wired components (resistors, for example), the connecting wire itself can be used as a via. This is not possible with cup electrolytic capacitors, as the wire is not accessible from above (on the cup side) and therefore cannot be soldered.

01.07.2026 | Summary of requirements for PCBs (Peter Breitschopf) | page 3

Via-inside diameter di

Via-outer diameter Da

Outer diameter of the pad > Da+0.5mm

di | da | Da | Material
0,4 | 0,6 | 1,0 | Silver
0,6 | 0,8 | 1,2 | Silver
0,6 | 0,8 | 1,4 | Copper
0,7 | 1,0 | 1,4 | Silver
0,8 | 1,0 | 1,6 | Copper
1,0 | 1,4 | 2,3 | Copper

(Via types; dimensions in mm; crossed-out types are not in stock, whether pressing tools are available must always be checked beforehand; vias marked in green are preferably used).

The manufacturer's specifications/limits must be observed for externally manufactured PCBs. This applies to all of the above considerations.

- Data required for milling machines (CAM):
- Drilling plated (drill holes)
- Copper top (conductor tracks on the top)
- Copper bottom (conductor tracks on the underside)
- Cutting Outside (outer edge of the circuit board)

The data must be available as Gerber data. If possible, the data should be exported as such:
- In inch format
- Data format 2:3 (number of digits before and after the decimal point)
- Leading and trailing zeros preserved
- Reference to relative zero point
In the case of deviations, data processing may be somewhat more time-consuming because the data formats have to be "tried out".
01.07.2026 | Summary of requirements for PCBs (Peter Breitschopf) | page 4

Via-inside diameter di

Via-outer diameter Da

Via-drill diameter da

And finally allways use filled layers where possible this lowers board manufacturing costs.

01.07.2026 | Summary of requirements for PCBs (Peter Breitschopf) | page 5
