Ayan161897/Impedance-git/PCB5/Impedance-measurement-3/Project-1.kicad_pcb

## KiCad design PCB5/Impedance-measurement-3/Project-1.kicad_pcb (2026-08-09)

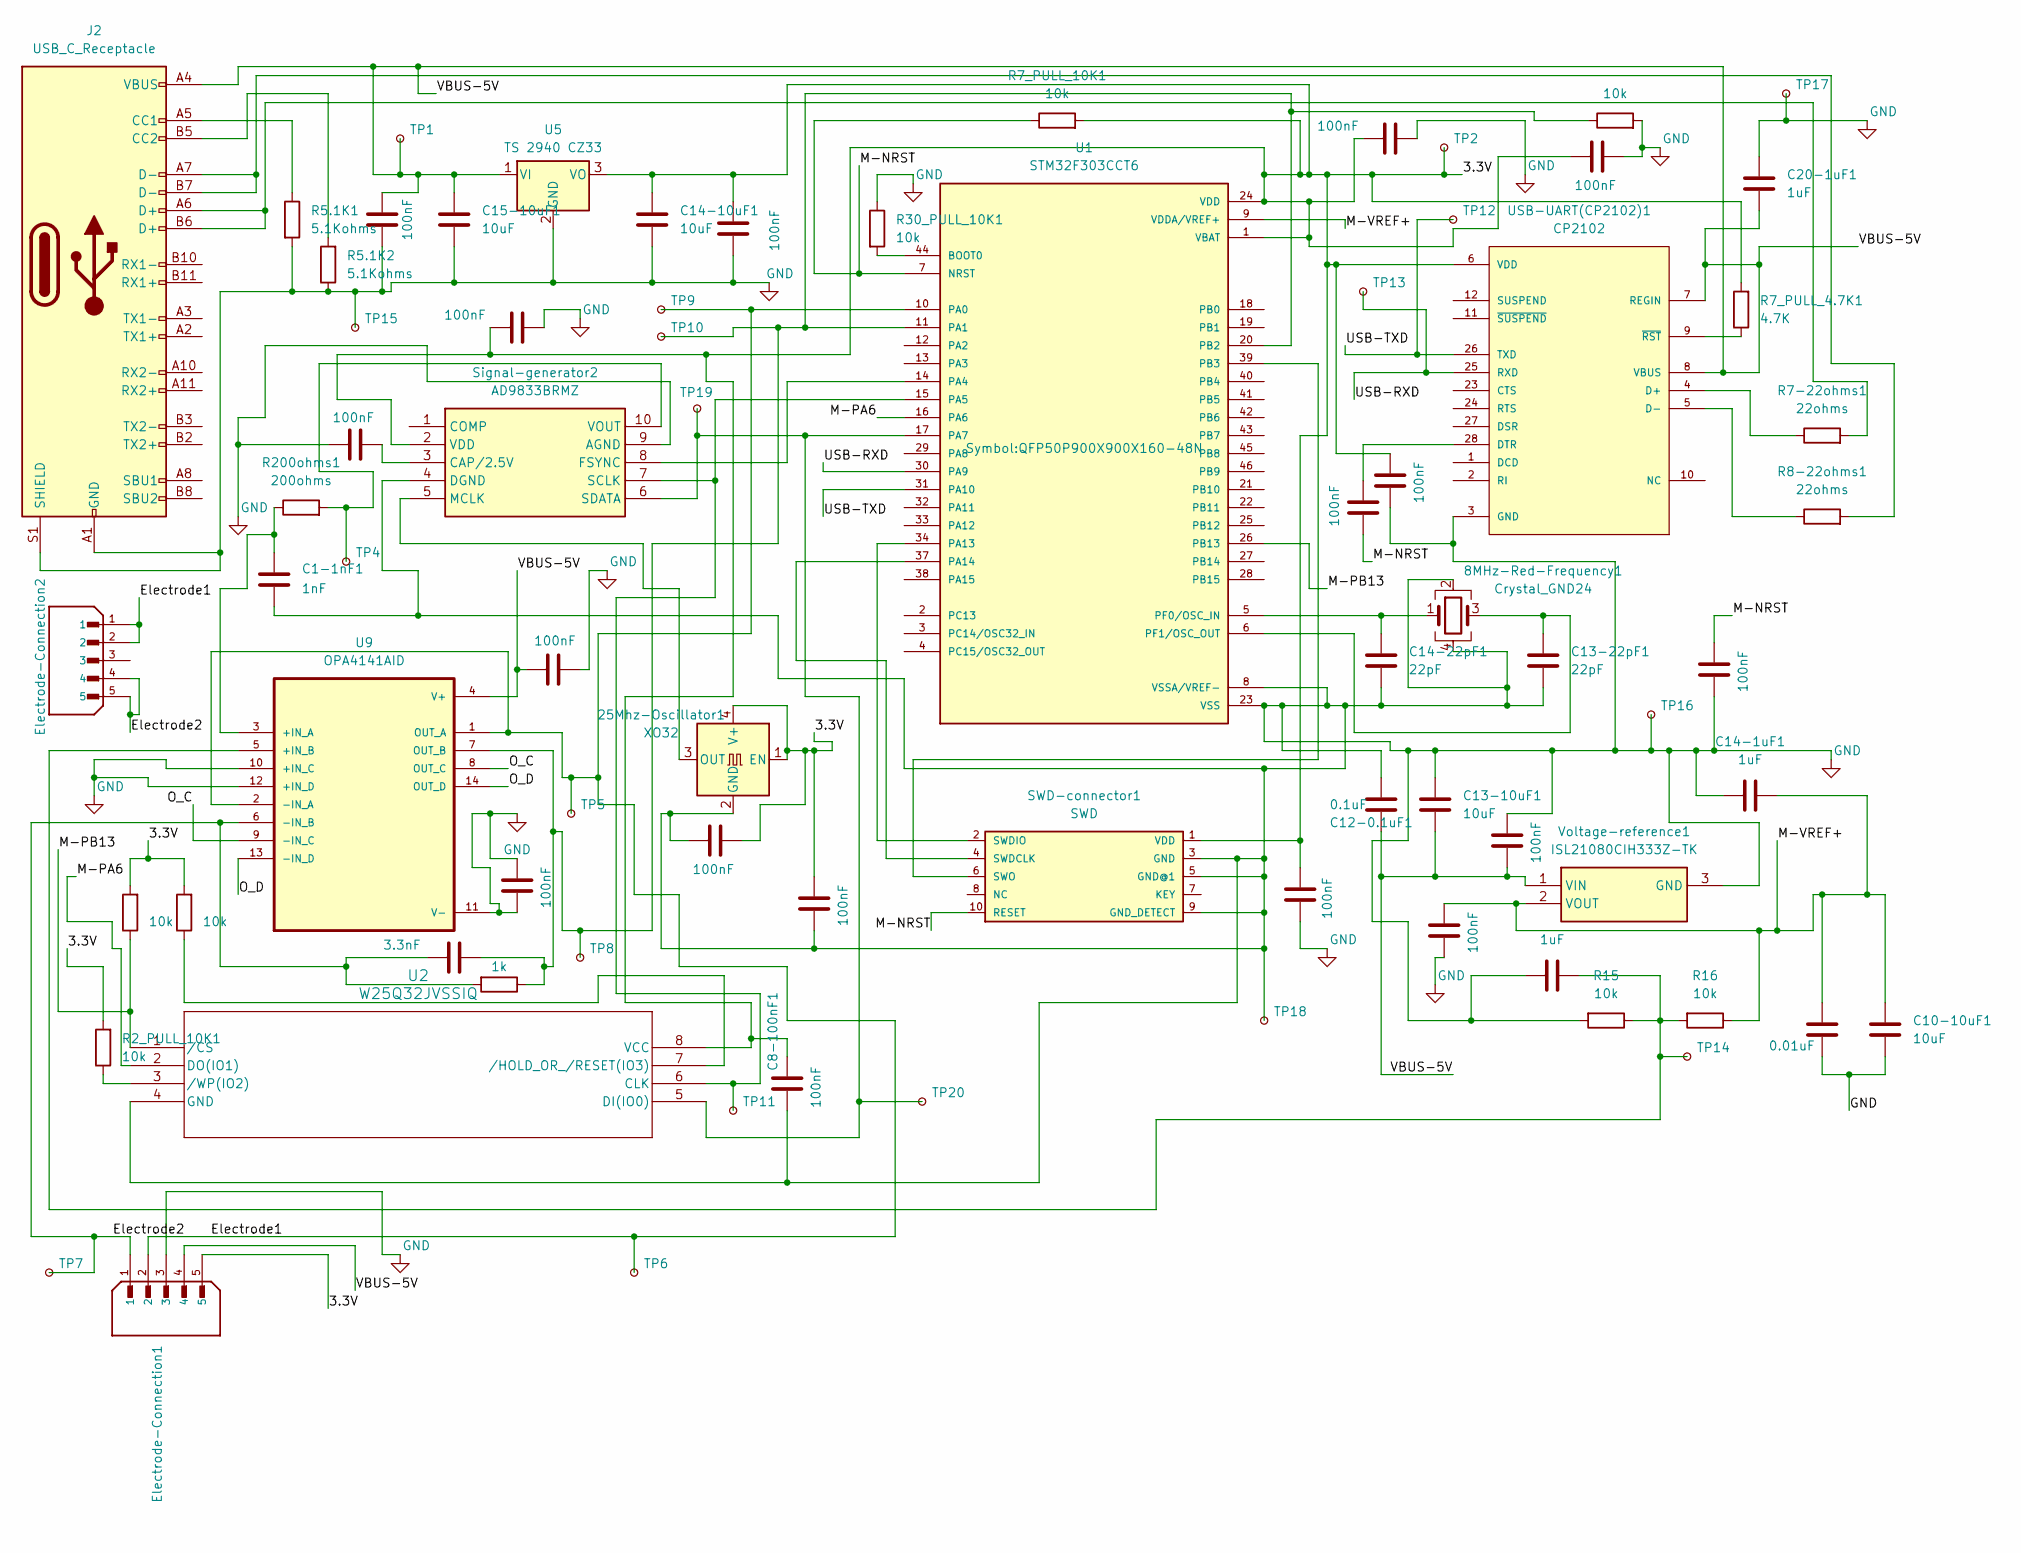
[picture p6: schematic Project-1.kicad_sch, Electrochemical Impedance Spectroscopy]

Parts:
8MHz-Red-Frequency1: Crystal_GND24; Crystal_SMD_5032-4Pin_5.0x3.2mm
25Mhz-Oscillator1: XO32; Oscillator_SMD_EuroQuartz_XO32-4Pin_3.2x2.5mm
C1-1nF1: 1nF; C_Axial_L3.8mm_D2.6mm_P7.50mm_Horizontal
C2-100nF1, C3-100nF1, C3-100nF2, C4-100nF1, C5-100nF1, C6-100nF1, C8-100nF1, C9-100nF1, C15-100nF1, C16-100nF1, C17-100nF1, C17-100nF2, C18-100nF1, C19-100nF1, C21-100nF1, C28-100nF1, C31-100nF1: 100nF; C_0805_2012Metric
C10-10uF1, C13-10uF1, C14-10uF1, C15-10uF1: 10uF; C_Axial_L3.8mm_D2.6mm_P7.50mm_Horizontal
C11-0.01uF1: 0.01uF; C_Axial_L3.8mm_D2.6mm_P7.50mm_Horizontal
C11-3.3nF1: 3.3nF; C_Axial_L3.8mm_D2.6mm_P7.50mm_Horizontal
C12-0.1uF1: 0.1uF; C_Axial_L3.8mm_D2.6mm_P7.50mm_Horizontal
C13-22pF1, C14-22pF1: 22pF; C_Axial_L3.8mm_D2.6mm_P7.50mm_Horizontal
C14-1uF1, C17, C20-1uF1: 1uF; C_Axial_L3.8mm_D2.6mm_P7.50mm_Horizontal
Electrode-Connection1, Electrode-Connection2: Cable-connector B5B-XH-A_LF__SN_; JST_B5B-XH-A_LF__SN_; PARTREV 7/4/21
J2: USB_C_Receptacle; USB_C_Receptacle_GCT_USB4115-03-C
R2_PULL_10K1, R3_PULL_10K1, R4_PULL_10K1, R7_PULL_10K1, R15, R16, R25_PULL_10K1, R30_PULL_10K1: 10k; R_Axial_DIN0204_L3.6mm_D1.6mm_P5.08mm_Horizontal
R5.1K1, R5.1K2: 5.1Kohms; R_Axial_DIN0204_L3.6mm_D1.6mm_P5.08mm_Horizontal
R5_1Kohms1: 1k; R_Axial_DIN0204_L3.6mm_D1.6mm_P5.08mm_Horizontal
R7-22ohms1, R8-22ohms1: 22ohms; R_Axial_DIN0204_L3.6mm_D1.6mm_P5.08mm_Horizontal
R7_PULL_4.7K1: 4.7K; R_Axial_DIN0204_L3.6mm_D1.6mm_P5.08mm_Horizontal
R200ohms1: 200ohms; R_Axial_DIN0204_L3.6mm_D1.6mm_P5.08mm_Horizontal
SWD-connector1: SWD; 2X10_BOXHEADER
Signal-generator2: AD9833BRMZ; SOP50P490X110-10N; Mouser Part Number 584-AD9833BRMZ
TP1, TP2, TP4, TP5, TP7, TP8, TP11, TP14, TP15, TP16, TP17, TP18: TestPoint_Small; TestPoint_Pad_D1.5mm
TP6, TP9, TP10, TP12, TP13, TP19, TP20: TestPoint_Small; TestPoint_Pad_D1.0mm
U1: STM32F303CCT6; QFP50P900X900X160-48N; PARTREV 14
U2: W25Q32JVSSIQ; SOIC-8_5.23x5.23mm_P1.27mm
U5: TS 2940 CZ33; TO-220-3_Vertical
U9: OPA4141AID; SOIC127P600X175-14N
USB-UART(CP2102)1: CP2102; QFN50P500X500X100-29N
Voltage-reference1: ISL21080CIH333Z-TK; SOT95P237X112-3N; Mouser Part Number 968-ISL21080CIH333ZT

Connections:
/Electrode1: Electrode-Connection1.2, Electrode-Connection2.1, Electrode-Connection2.2, TP5.1, TP6.1, TP9.1, U1.10 (PA0), U9.1 (OUT_A), U9.2 (-IN_A)
/Electrode2: C11-3.3nF1.1, Electrode-Connection1.1, Electrode-Connection2.4, Electrode-Connection2.5, R5_1Kohms1.2, TP7.1, U9.6 (-IN_B)
/M-NRST: C3-100nF1.1, C5-100nF1.2, R7_PULL_10K1.1, SWD-connector1.10 (RESET), U1.7 (NRST)
/M-PA6: U1.16 (PA6), U2.2 (DO(IO1))
/M-PB13: R3_PULL_10K1.1, U1.26 (PB13), U2.1 (/CS)
/M-VREF+: C10-10uF1.1, C11-0.01uF1.1, C14-1uF1.2, C18-100nF1.2, R16.1, U1.9 (VDDA/VREF+), Voltage-reference1.2 (VOUT)
/O_C: U9.8 (OUT_C), U9.9 (-IN_C)
/O_D: U9.13 (-IN_D), U9.14 (OUT_D)
/USB-RXD: TP13.1, U1.30 (PA9), USB-UART(CP2102)1.25 (RXD)
/USB-TXD: TP12.1, U1.31 (PA10), USB-UART(CP2102)1.26 (TXD)
/VBUS-5V: C2-100nF1.2, C12-0.1uF1.2, C13-10uF1.2, C15-10uF1.1, C20-1uF1.1, C21-100nF1.2, C28-100nF1.1, Electrode-Connection1.4, J2.A4 (VBUS), J2.A9 (VBUS), J2.B4 (VBUS), J2.B9 (VBUS), TP1.1, U5.1 (VI), U9.4 (V+), USB-UART(CP2102)1.7 (REGIN), USB-UART(CP2102)1.8 (VBUS), Voltage-reference1.1 (VIN)
GND: 8MHz-Red-Frequency1.2, 8MHz-Red-Frequency1.4, 25Mhz-Oscillator1.2 (GND), C1-1nF1.2, C2-100nF1.1, C3-100nF2.1, C3-100nF2.2, C4-100nF1.1, C5-100nF1.1, C6-100nF1.1, C8-100nF1.1, C9-100nF1.1, C10-10uF1.2, C11-0.01uF1.2, C12-0.1uF1.1, C13-10uF1.1, C13-22pF1.2, C14-1uF1.1, C14-10uF1.2, C14-22pF1.2, C15-10uF1.2, C15-100nF1.1, C16-100nF1.2, C17.1, C17-100nF1.2, C17-100nF2.1, C18-100nF1.1, C19-100nF1.2, C20-1uF1.2, C21-100nF1.1, C28-100nF1.2, C31-100nF1.1, Electrode-Connection1.3, J2.A1 (GND), J2.A12 (GND), J2.B1 (GND), J2.B12 (GND), J2.S1 (SHIELD), R5.1K1.2, R5.1K2.1, R15.2, R25_PULL_10K1.2, R30_PULL_10K1.1, SWD-connector1.3 (GND), SWD-connector1.5 (GND@1), SWD-connector1.9 (GND_DETECT), Signal-generator2.4 (DGND), Signal-generator2.9 (AGND), TP15.1, TP16.1, TP17.1, TP18.1, U1.8 (VSSA/VREF-), U1.23 (VSS), U1.35 (VSS), U1.47 (VSS), U2.4 (GND), U5.2 (GND), U9.10 (+IN_C), U9.11 (V-), U9.12 (+IN_D), USB-UART(CP2102)1.3 (GND), USB-UART(CP2102)1.29 (GND), Voltage-reference1.3 (GND)
unnamed: 25Mhz-Oscillator1.3 (OUT), Signal-generator2.5 (MCLK)
unnamed: J2.A5 (CC1), R5.1K1.1
unnamed: J2.B5 (CC2), R5.1K2.2
unnamed: J2.A6 (D+), J2.B6 (D+), R7-22ohms1.2
unnamed: J2.A7 (D-), J2.B7 (D-), R8-22ohms1.2
unnamed: SWD-connector1.4 (SWDCLK), U1.37 (PA14)
unnamed: SWD-connector1.2 (SWDIO), U1.34 (PA13)
unnamed: SWD-connector1.6 (SWO), U1.39 (PB3)
unnamed: C15-100nF1.2, Signal-generator2.3 (CAP/2.5V)
unnamed: Signal-generator2.8 (FSYNC), U1.14 (PA4)
unnamed: Signal-generator2.7 (SCLK), TP11.1, U1.15 (PA5), U2.6 (CLK)
unnamed: Signal-generator2.6 (SDATA), TP19.1, TP20.1, U1.17 (PA7), U2.5 (DI(IO0))
unnamed: R200ohms1.2, Signal-generator2.10 (VOUT), TP4.1
unnamed: R30_PULL_10K1.2, U1.44 (BOOT0)
unnamed: C11-3.3nF1.2, R5_1Kohms1.1, R25_PULL_10K1.1, TP8.1, TP10.1, U1.11 (PA1), U1.20 (PB2), U9.7 (OUT_B)
unnamed: 8MHz-Red-Frequency1.1, C14-22pF1.1, U1.5 (PF0/OSC_IN)
unnamed: 8MHz-Red-Frequency1.3, C13-22pF1.1, U1.6 (PF1/OSC_OUT)
unnamed: R4_PULL_10K1.1, U2.7 (/HOLD_OR_/RESET(IO3))
unnamed: R2_PULL_10K1.1, U2.3 (/WP(IO2))
unnamed: C1-1nF1.1, R200ohms1.1, U9.3 (+IN_A)
unnamed: C17.2, R15.1, R16.2, TP14.1, U9.5 (+IN_B)
unnamed: R7-22ohms1.1, USB-UART(CP2102)1.4 (D+)
unnamed: R8-22ohms1.1, USB-UART(CP2102)1.5 (D-)
unnamed: C3-100nF1.2, USB-UART(CP2102)1.28 (DTR)
unnamed: USB-UART(CP2102)1.10 (NC), USB-UART(CP2102)1.13 (NC), USB-UART(CP2102)1.14 (NC), USB-UART(CP2102)1.15 (NC), USB-UART(CP2102)1.16 (NC), USB-UART(CP2102)1.17 (NC), USB-UART(CP2102)1.18 (NC), USB-UART(CP2102)1.19 (NC), USB-UART(CP2102)1.20 (NC), USB-UART(CP2102)1.21 (NC), USB-UART(CP2102)1.22 (NC)
unnamed: R7_PULL_4.7K1.1, USB-UART(CP2102)1.9 (~RST)
VDD: 25Mhz-Oscillator1.1 (EN), 25Mhz-Oscillator1.4 (V+), C4-100nF1.2, C6-100nF1.2, C8-100nF1.2, C9-100nF1.2, C14-10uF1.1, C16-100nF1.1, C17-100nF1.1, C17-100nF2.2, C19-100nF1.1, C31-100nF1.2, Electrode-Connection1.5, R2_PULL_10K1.2, R3_PULL_10K1.2, R4_PULL_10K1.2, R7_PULL_4.7K1.2, R7_PULL_10K1.2, SWD-connector1.1 (VDD), Signal-generator2.2 (VDD), TP2.1, U1.1 (VBAT), U1.24 (VDD), U1.36 (VDD), U1.48 (VDD), U2.8 (VCC), U5.3 (VO), USB-UART(CP2102)1.6 (VDD)

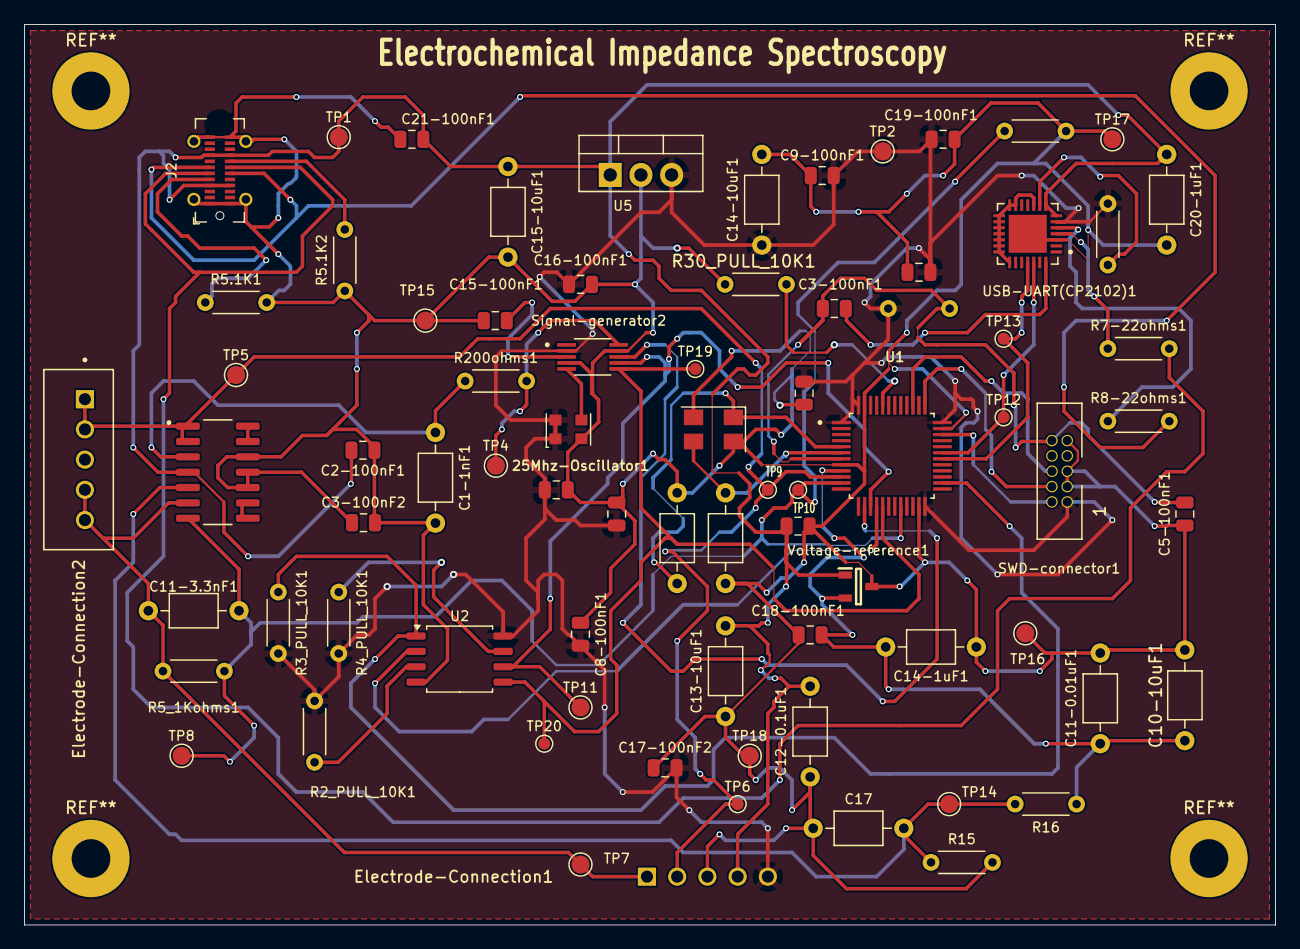
[picture p7: board Project-1.kicad_pcb from above]

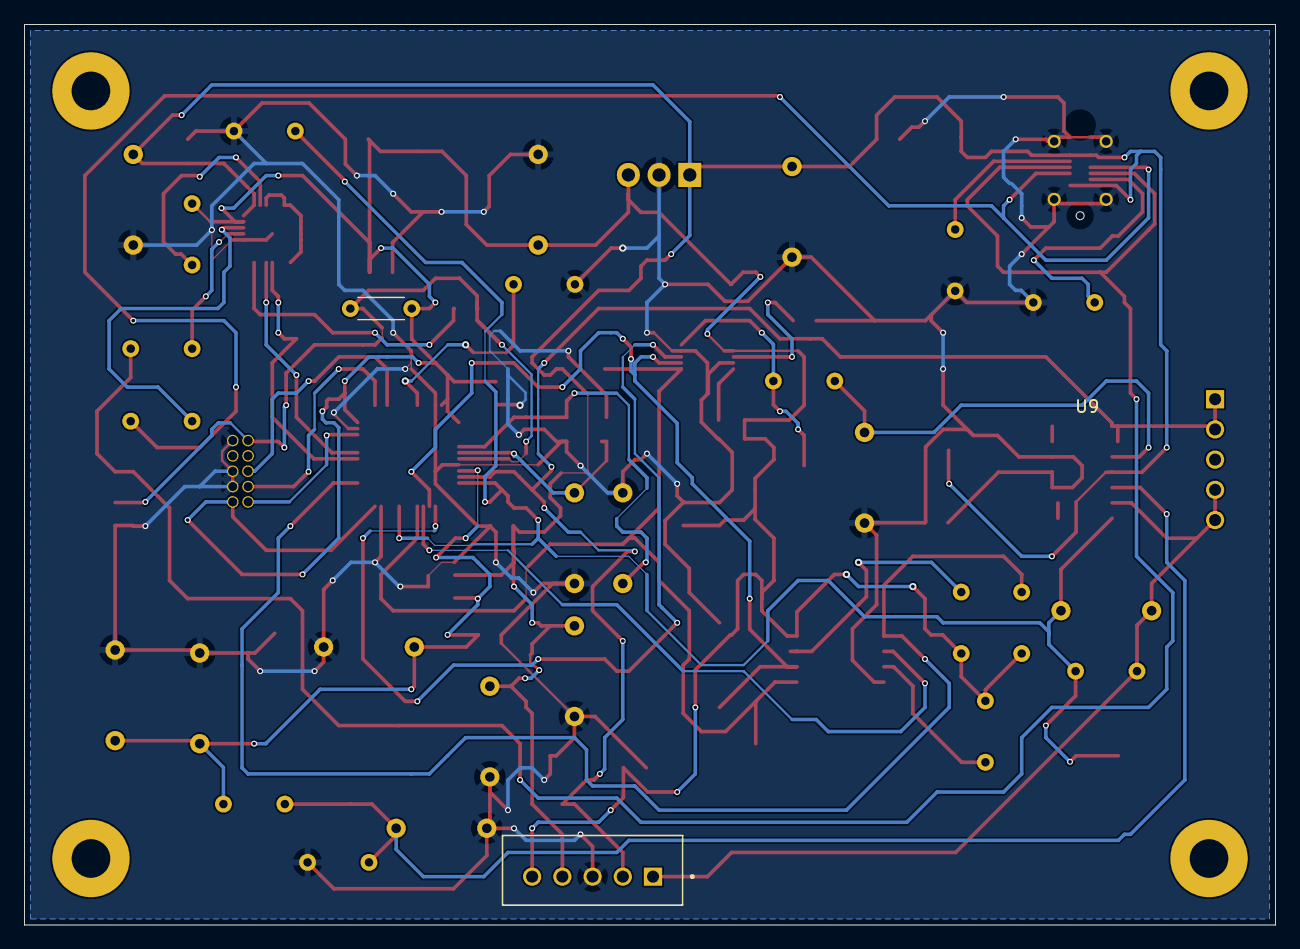
[picture p8: board Project-1.kicad_pcb from below]

Board: 2 copper layers, 103.5 x 74.5 mm, 77 parts (2 on the bottom side), 39 nets.
