Ayan161897/Impedance-git/Core/Src/main.c

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
/* Includes ------------------------------------------------------------------*/
#include "main.h"

/* USER CODE BEGIN Includes */
#include "ad9833.h"
#include "impedance.h"
#include "w25q32.h"
#include "flash_log.h"
#include <stdio.h>
#include "uart_comm.h"
/* USER CODE END Includes */

ADC_HandleTypeDef hadc1;
DMA_HandleTypeDef hdma_adc1;

SPI_HandleTypeDef hspi1;

UART_HandleTypeDef huart1;

/* USER CODE BEGIN PV */

uint8_t tx_buffer[64];

uint8_t rx_buffer[64];

uint32_t flash_id;

volatile uint8_t measurement_running = 0;

static uint32_t sweep_start_frequency = SWEEP_START_FREQUENCY;
static uint32_t sweep_stop_frequency = SWEEP_STOP_FREQUENCY;
static uint32_t sweep_step_frequency = SWEEP_STEP_FREQUENCY;
static float feedback_resistor = 1000.0f;  /* PCB5 R5 — reported in STATUS only */

/* USER CODE END PV */

void SystemClock_Config(void);
static void MX_GPIO_Init(void);
static void MX_DMA_Init(void);
static void MX_ADC1_Init(void);
static void MX_SPI1_Init(void);
static void MX_USART1_UART_Init(void);
/* USER CODE BEGIN 0 */

static void Send_Status(void)
{
    uint32_t rf_x100 = (uint32_t)((feedback_resistor * 100.0f) + 0.5f);

    printf("STATUS,%s,START=%lu,STOP=%lu,STEP=%lu,RF=%lu.%02lu,CF_NF=3.30,FLASH_COUNT=%lu\r\n",
           measurement_running ? "RUNNING" : "IDLE",
           sweep_start_frequency,
           sweep_stop_frequency,
           sweep_step_frequency,
           rf_x100 / 100U,
           rf_x100 % 100U,
           FlashLog_GetRecordCount());
}

static int32_t Scale_Float_X100(float value)
{
    if(value >= 0.0f)
    {
        return (int32_t)((value * 100.0f) + 0.5f);
    }

    return (int32_t)((value * 100.0f) - 0.5f);
}

static void Send_Flash_Record(const FlashLogRecord *record)
{
    uint32_t magnitude_x100 = (uint32_t)((record->magnitude * 100.0f) + 0.5f);
    int32_t phase_x100 = Scale_Float_X100(record->phase_deg);
    int32_t real_x100 = Scale_Float_X100(record->real);
    int32_t imag_x100 = Scale_Float_X100(record->imag);

    printf("FLASH_DATA,%lu,%lu,%ld,%ld,%ld\r\n",
           (unsigned long)record->freq_hz,
           (unsigned long)magnitude_x100,
           (long)phase_x100,
           (long)real_x100,
           (long)imag_x100);
}

static uint8_t Sweep_Config_IsValid(void)
{
    return (sweep_start_frequency > 0U) &&
           (sweep_stop_frequency >= sweep_start_frequency) &&
           (sweep_step_frequency > 0U) &&
           (feedback_resistor > 0.0f);
}

static void Delay_With_Command_Processing(uint32_t delay_ms)
{
    uint32_t elapsed = 0U;

    while(elapsed < delay_ms)
    {
        UART_ProcessCommand();

        if(!measurement_running)
        {
            break;
        }

        HAL_Delay(10);
        elapsed += 10U;
    }
}

int __io_putchar(int ch)
{
    HAL_UART_Transmit(&huart1,
                      (uint8_t *)&ch,
                      1,
                      HAL_MAX_DELAY);

    return ch;
}

void Process_Start_Command(void)
{
    if(measurement_running)
    {
        UART_SendString("ERROR,BUSY\r\n");
        return;
    }
    if(!Sweep_Config_IsValid())
    {
        UART_SendString("ERROR,BAD_CONFIG\r\n");
        return;
    }

    if(FlashLog_BeginSweep() != FLASH_LOG_OK)
    {
        UART_SendString("ERROR,FLASH_ERASE\r\n");
        return;
    }

    measurement_running = 1;
    UART_SendString("OK START\r\n");
}

void Process_Stop_Command(void)
{
    measurement_running = 0;
    UART_SendString("OK STOP\r\n");
}

void Process_Status_Command(void)
{
    Send_Status();
}

void Process_FlashStatus_Command(void)
{
    printf("FLASH_STATUS,COUNT=%lu,CAPACITY=%lu\r\n",
           (unsigned long)FlashLog_GetRecordCount(),
           (unsigned long)FlashLog_GetCapacity());
}

void Process_EraseFlash_Command(void)
{
    if(measurement_running)
    {
        UART_SendString("ERROR,BUSY\r\n");
        return;
    }

    if(FlashLog_Erase() == FLASH_LOG_OK)
    {
        UART_SendString("OK ERASE_FLASH\r\n");
    }
    else
    {
        UART_SendString("ERROR,FLASH_ERASE\r\n");
    }
}

void Process_DumpFlash_Command(void)
{
    uint32_t count = FlashLog_GetRecordCount();

    if(measurement_running)
    {
        UART_SendString("ERROR,BUSY\r\n");
        return;
    }

    printf("FLASH_DUMP,BEGIN,COUNT=%lu\r\n",
           (unsigned long)count);
    UART_SendString("FLASH_DUMP,FORMAT,FREQ_HZ,MAG_X100,PHASE_X100,REAL_X100,IMAG_X100\r\n");

    for(uint32_t i = 0; i < count; i++)
    {
        FlashLogRecord record;

        if(FlashLog_ReadRecord(i, &record) == FLASH_LOG_OK)
        {
            Send_Flash_Record(&record);
        }
        else
        {
            printf("FLASH_DUMP,ERROR,INDEX=%lu\r\n",
                   (unsigned long)i);
            break;
        }
    }

    UART_SendString("FLASH_DUMP,END\r\n");
}

void Process_SetStartFrequency(uint32_t value)
{
    if(measurement_running || value == 0U || value > sweep_stop_frequency || value > (AD9833_MCLK / 2UL))
    {
        UART_SendString("ERROR,BAD_VALUE\r\n");
        return;
    }

    sweep_start_frequency = value;
    UART_SendString("OK SET_START_FREQ\r\n");
}

void Process_SetStopFrequency(uint32_t value)
{
    if(measurement_running || value < sweep_start_frequency || value > (AD9833_MCLK / 2UL))
    {
        UART_SendString("ERROR,BAD_VALUE\r\n");
        return;
    }

    sweep_stop_frequency = value;
    UART_SendString("OK SET_STOP_FREQ\r\n");
}

void Process_SetStepFrequency(uint32_t value)
{
    if(measurement_running || value == 0U)
    {
        UART_SendString("ERROR,BAD_VALUE\r\n");
        return;
    }

    sweep_step_frequency = value;
    UART_SendString("OK SET_STEP_FREQ\r\n");
}

void Process_SetFeedbackResistor(float value)
{
    (void)value;
    UART_SendString("ERROR,FIXED_TIA,RF=1000.00,CF_NF=3.30\r\n");
}

void Process_SetSweepConfig(uint32_t start, uint32_t stop, uint32_t step)
{
    if(measurement_running)
    {
        UART_SendString("ERROR,BUSY\r\n");
        return;
    }
    if(start == 0U || step == 0U || stop < start || stop > (AD9833_MCLK / 2UL))
    {
        UART_SendString("ERROR,BAD_VALUE\r\n");
        return;
    }
    sweep_start_frequency = start;
    sweep_stop_frequency  = stop;
    sweep_step_frequency  = step;
    UART_SendString("OK SET_SWEEP\r\n");
}

/* USER CODE END 0 */

/**
  * @brief  The application entry point.
  * @retval int
  */
int main(void)
{

  /* MCU Configuration--------------------------------------------------------*/

  /* Reset of all peripherals, Initializes the Flash interface and the Systick. */
  HAL_Init();

  /* Configure the system clock */
  SystemClock_Config();

  /* Initialize all configured peripherals */
  MX_GPIO_Init();
  MX_DMA_Init();
  MX_ADC1_Init();
  MX_SPI1_Init();
  MX_USART1_UART_Init();
  /* USER CODE BEGIN 2 */

  UART_Comm_Init(&huart1);

  printf("BOOT,STM32F303CCT6_EIS\r\n");

  /* =========================================
     ADC CALIBRATION
     ========================================= */

  /* =========================================
     IMPEDANCE MODULE INIT
     ========================================= */

  Imp_Init();

  /* =========================================
     SPI FLASH INIT
     ========================================= */

  W25Q32_Init(&hspi1);

  flash_id = W25Q32_ReadID();

  if(flash_id != W25Q32_JEDEC_ID)
  {
      printf("BOOT,WARNING,FLASH_ID_MISMATCH,EXPECTED=0x%06lX,GOT=0x%06lX\r\n",
             (unsigned long)W25Q32_JEDEC_ID,
             (unsigned long)(flash_id & 0x00FFFFFFUL));
  }

  printf("FLASH,ID,0x%08lX\r\n",
         flash_id);

  FlashLog_Init();

  /* =========================================
     AD9833 INIT
     ========================================= */

  AD9833_Init();

  AD9833_SetWaveform(AD9833_SINE);

  AD9833_SetFrequency(sweep_start_frequency);

  printf("READY\r\n");
  Send_Status();

  /* USER CODE END 2 */

  /* Infinite loop */
  /* USER CODE BEGIN WHILE */
  while (1)
  {
    /* USER CODE END WHILE */

    /* USER CODE BEGIN 3 */
    UART_ProcessCommand();

    if(measurement_running)
    {
        BodePoint result;

        UART_SendString("SWEEP,BEGIN\r\n");

        uint32_t freq = sweep_start_frequency;
        while(1)
        {
            UART_ProcessCommand();

            if(!measurement_running)
            {
                break;
            }

            AD9833_SetFrequency(freq);

            Delay_With_Command_Processing(20);

            if(!measurement_running)
            {
                break;
            }

            result = Imp_MeasureAtFrequency(freq);

            UART_SendImpedanceData(freq,
                                   result.magnitude,
                                   result.phaseDeg,
                                   result.realPart,
                                   result.imagPart);

            FlashLogStatus flash_status =
                    FlashLog_WritePoint(freq, &result);

            if(flash_status == FLASH_LOG_FULL)
            {
                UART_SendString("ERROR,FLASH_FULL\r\n");
            }
            else if(flash_status != FLASH_LOG_OK)
            {
                UART_SendString("ERROR,FLASH_WRITE\r\n");
            }

            if(freq >= sweep_stop_frequency)
            {
                break;
            }

            /* Overflow-safe increment: clamp to stop if next step overshoots.
               (freq < sweep_stop_frequency here, so this subtraction cannot
               underflow, unlike computing sweep_stop_frequency - sweep_step_frequency
               directly when step > span.) */
            if(sweep_step_frequency >= (sweep_stop_frequency - freq))
            {
                freq = sweep_stop_frequency;
            }
            else
            {
                freq += sweep_step_frequency;
            }

            Delay_With_Command_Processing(SWEEP_DELAY_MS);
        }

        measurement_running = 0;
        UART_SendString("SWEEP,DONE\r\n");
        Send_Status();
    }
  }
  /* USER CODE END 3 */
}

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
