Ayan161897/Impedance-git/Impedance-measurement-git.ioc

Mcu.UserName=STM32F303CCTx
PA0.Signal=ADC1_IN1
PA1.Signal=ADC1_IN2
PA10.Signal=USART1_RX
PA13.Signal=SYS_JTMS-SWDIO
PA14.Signal=SYS_JTCK-SWCLK
PA4.GPIO_Label=AD9833_FSYNC
PA4.Signal=GPIO_Output
PA5.Signal=SPI1_SCK
PA6.Signal=SPI1_MISO
PA7.Signal=SPI1_MOSI
PA9.Signal=USART1_TX
PB12.GPIO_Label=W25Q32_CS
PB12.Signal=GPIO_Output
PB13.GPIO_Label=STATUS_LED
PB13.Signal=GPIO_Output
PB2.Signal=GPIO_Analog
PB3.Signal=SYS_JTDO-TRACESWO
PF0-OSC_IN.Signal=RCC_OSC_IN
PF1-OSC_OUT.Signal=RCC_OSC_OUT
