Ayan161897/Impedance-git/Core/Inc/main.h

#define AD9833_FSYNC_Pin GPIO_PIN_4
#define AD9833_FSYNC_GPIO_Port GPIOA
#define W25Q32_CS_Pin GPIO_PIN_13
#define W25Q32_CS_GPIO_Port GPIOB
#define SWEEP_START_FREQUENCY     5000U
#define SWEEP_STOP_FREQUENCY      100000U
#define SWEEP_STEP_FREQUENCY      1000U
#define SWEEP_DELAY_MS            100
