Ayan161897/Impedance-git/Core/Src/ad9833.c

/**
 ******************************************************************************
 * @file           : ad9833.c
 * @brief          : AD9833 DDS Driver
 ******************************************************************************
 */

#include "ad9833.h"
#include "main.h"

extern SPI_HandleTypeDef hspi1;

/* =========================================================
   FSYNC CONTROL
   ========================================================= */

#define FSYNC_LOW() \
    HAL_GPIO_WritePin(AD9833_FSYNC_GPIO_Port, \
                      AD9833_FSYNC_Pin, \
                      GPIO_PIN_RESET)

#define FSYNC_HIGH() \
    HAL_GPIO_WritePin(AD9833_FSYNC_GPIO_Port, \
                      AD9833_FSYNC_Pin, \
                      GPIO_PIN_SET)

/* =========================================================
   WRITE REGISTER
   ========================================================= */

void AD9833_WriteRegister(uint16_t data)
{
    uint8_t tx[2];

    tx[0] = (data >> 8) & 0xFF;
    tx[1] = data & 0xFF;

    /* AD9833 requires SPI Mode 2 (CPOL=1, CPHA=0): clock idle HIGH.
       SPI1 is normally in Mode 0 for the W25Q32, so switch here and
       restore afterwards. SPE must be cleared before changing CPOL. */
    hspi1.Instance->CR1 &= ~SPI_CR1_SPE;
    hspi1.Instance->CR1 = (hspi1.Instance->CR1 & ~SPI_CR1_CPHA) | SPI_CR1_CPOL;
    hspi1.Instance->CR1 |= SPI_CR1_SPE;

    FSYNC_LOW();

    HAL_SPI_Transmit(&hspi1,
                     tx,
                     2,
                     HAL_MAX_DELAY);

    FSYNC_HIGH();

    /* Restore Mode 0 (CPOL=0, CPHA=0) for W25Q32 */
    hspi1.Instance->CR1 &= ~SPI_CR1_SPE;
    hspi1.Instance->CR1 &= ~(SPI_CR1_CPOL | SPI_CR1_CPHA);
    hspi1.Instance->CR1 |= SPI_CR1_SPE;
}

/* =========================================================
   RESET
   ========================================================= */

void AD9833_Reset(void)
{
    AD9833_WriteRegister(AD9833_B28 | AD9833_RESET);
}

/* =========================================================
   INITIALIZATION
   ========================================================= */

void AD9833_Init(void)
{
    AD9833_Reset();

    HAL_Delay(10);

    AD9833_SetFrequency(1000);

    AD9833_SetPhase(0);

    AD9833_SetSineOutput();
}

/* =========================================================
   SET FREQUENCY
   ========================================================= */

void AD9833_SetFrequency(uint32_t frequency)
{
    uint32_t freqWord;

    uint16_t lsb;
    uint16_t msb;

    freqWord =
        (uint32_t)((double)frequency *
        268435456.0 /
        AD9833_MCLK);

    lsb =
        AD9833_FREQ0_REGISTER |
        (freqWord & 0x3FFF);

    msb =
        AD9833_FREQ0_REGISTER |
        ((freqWord >> 14) & 0x3FFF);

    /* Write B28 control word (no RESET) then both frequency words.
       Omitting RESET keeps the DAC running between frequency steps,
       preventing output glitches during a sweep. */
    AD9833_WriteRegister(AD9833_B28);

    AD9833_WriteRegister(lsb);

    AD9833_WriteRegister(msb);
}

/* =========================================================
   SET PHASE
   ========================================================= */

void AD9833_SetPhase(uint16_t phase)
{
    uint16_t phaseWord;

    phaseWord =
        (uint16_t)((phase * 4096.0f) / 360.0f);

    AD9833_WriteRegister(
        AD9833_PHASE0_REGISTER |
        (phaseWord & 0x0FFF));
}

/* =========================================================
   SET WAVEFORM
   ========================================================= */

void AD9833_SetWaveform(AD9833_Mode mode)
{
    switch(mode)
    {
        case AD9833_TRIANGLE:

            AD9833_WriteRegister(
                AD9833_B28 |
                AD9833_MODE);

            break;

        case AD9833_SQUARE:

            AD9833_WriteRegister(
                AD9833_B28 |
                AD9833_OPBITEN |
                AD9833_DIV2);

            break;

        case AD9833_SINE:
        default:

            AD9833_WriteRegister(
                AD9833_B28);

            break;
    }
}

/* =========================================================
   SINE OUTPUT
   ========================================================= */

void AD9833_SetSineOutput(void)
{
    AD9833_SetWaveform(AD9833_SINE);
}

/* =========================================================
   TRIANGLE OUTPUT
   ========================================================= */

void AD9833_SetTriangleOutput(void)
{
    AD9833_SetWaveform(AD9833_TRIANGLE);
}

/* =========================================================
   SQUARE OUTPUT
   ========================================================= */

void AD9833_SetSquareOutput(void)
{
    AD9833_SetWaveform(AD9833_SQUARE);
}
