Ayan161897/Impedance-git/(commit log)

2026-05-22 Fix build errors: add missing ADC and SPI HAL drivers, enable modules in hal_conf
    The project used ADC and SPI peripherals but the required HAL driver files were
    missing from the repository and both modules were disabled in hal_conf.h.
    - Add stm32f3xx_hal_adc.h/c, stm32f3xx_hal_adc_ex.h/c, stm32f3xx_hal_spi.h/c
    and stm32f3xx_hal_spi_ex.h from the official STM32F3xx HAL driver library
    - Enable HAL_ADC_MODULE_ENABLED and HAL_SPI_MODULE_ENABLED in stm32f3xx_hal_conf.h
    - Update Debug/Drivers/.../subdir.mk to compile the new ADC and SPI source files
2026-05-28 Update SPI included
2026-07-01 Update 01/07/2026 SPI Flash included
2026-07-04 user interface included on 4/7/2026
    [Project-1.csv, Project-1.kicad_pcb, Project-1.kicad_sch, Project-1.xlsx]
2026-07-04 Phase error removed on 4/7/2026
    [Project-1.xlsx]
2026-07-06 mounting holes included 6/7/2026
    [Project-1.csv, Project-1.kicad_sch, Project-1.xlsx]
2026-07-06 mounting holes included 7/7/2026
2026-07-17 schematic and layout changed 7/7/2026
    [Project-1.kicad_pcb, Project-1.kicad_sch]
2026-07-25 schematic and layout changed 25/7/2026
2026-07-26 schematic and layout changed 26/7/2026
    [Project-1.kicad_pcb]
2026-07-26 schematic and layout changed second time in 26/7/2026
    [Project-1.kicad_pcb, Project-1.kicad_sch]
2026-07-26 schematic and layout changed third time in 26/7/2026
2026-07-31 new PCB2 included on 31/7/2026
    [Project-1-B_Cu.gbr, Project-1-B_Mask.gbr, Project-1-B_Paste.gbr, Project-1-B_Silkscreen.gbr, Project-1-Edge_Cuts.gbr, Project-1-F_Cu.gbr, Project-1-F_Mask.gbr, Project-1-F_Paste.gbr]
2026-08-01 new PCB3 with boot 0 and op-amp v- pin corrected included on 1/8/2026
    [Project-1.kicad_pcb, Project-1.kicad_sch]
2026-08-01 new PCB4 with Vbat connected to Vdd included on 1/8/2026
    [Project-1.kicad_pcb, Project-1.kicad_sch]
2026-08-02 software modified for PB2 on 1/8/2026
    [Project-1-B_Cu.gbr, Project-1-B_Mask.gbr, Project-1-B_Paste.gbr, Project-1-B_Silkscreen.gbr, Project-1-Edge_Cuts.gbr, Project-1-F_Cu.gbr, Project-1-F_Mask.gbr, Project-1-F_Paste.gbr]
2026-08-09 Led removed 9/8/2026
    [Project-1-B_Cu.gbr, Project-1-B_Mask.gbr, Project-1-B_Paste.gbr, Project-1-B_Silkscreen.gbr, Project-1-Edge_Cuts.gbr, Project-1-F_Cu.gbr, Project-1-F_Mask.gbr, Project-1-F_Paste.gbr]
